ShawnHymel/Matrix_Badge/Images/border-film.png

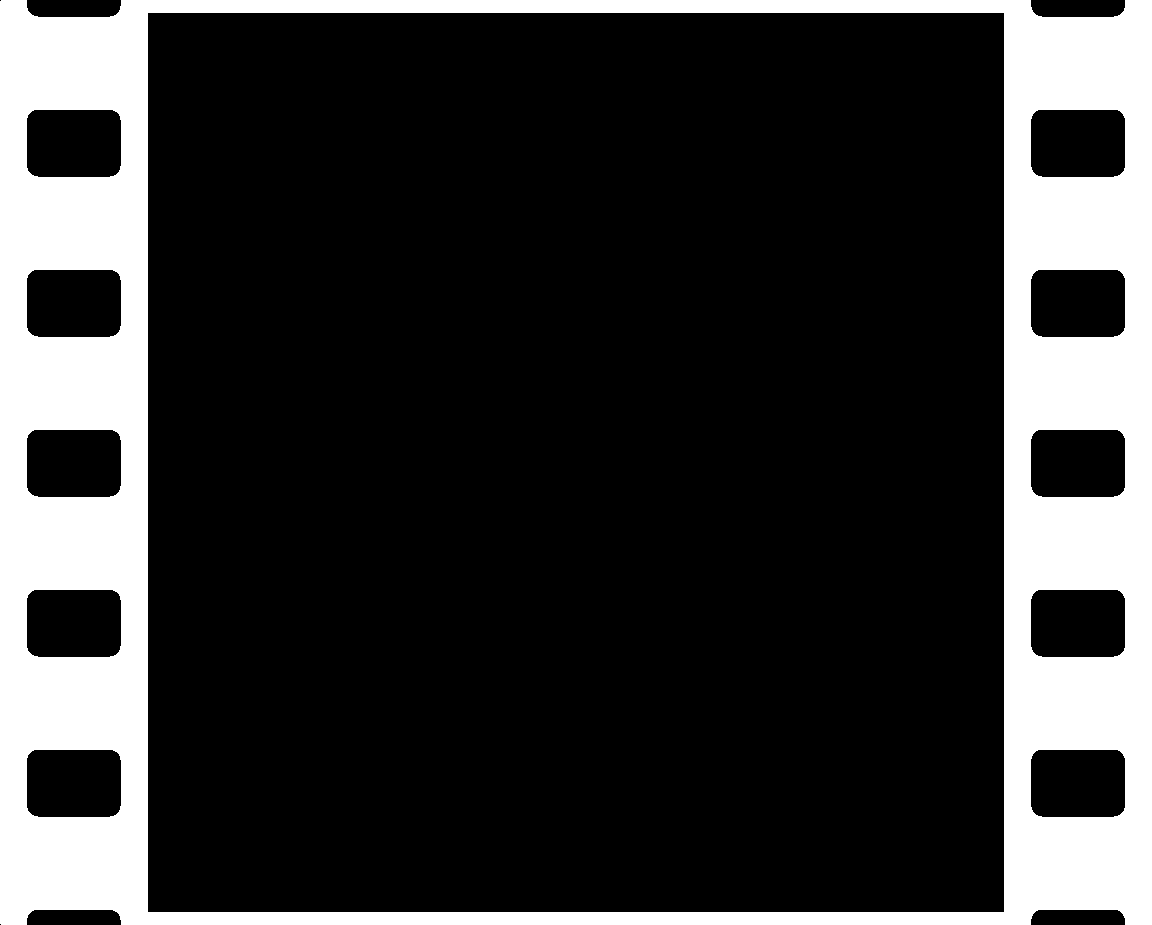
Images/border-film.png
