ShawnHymel/Matrix_Badge/Hardware/chplex-bom.xlsx

Reference | Quantity | Value | Footprint | MPN | Price/1 | Total Price/1 | Price/1k | Total Price/1k | Part Page
BT1 | 1 | Battery_Cell | Battery:BatteryHolder_Keystone_3034_1x20mm | 3034TR | $0.35000 | $0.35000 | $0.17504 | $0.17504 | https://www.digikey.com/product-detail/en/keystone-electronics/3034TR/36-3034CT-ND/4833649
C1 | 1 | 4.7uF | Capacitor_SMD:C_0805_2012Metric_Pad1.15x1.40mm_HandSolder | TMK212AB7475KG-T | $0.34000 | $0.34000 | $0.08151 | $0.08151 | https://www.digikey.com/product-detail/en/taiyo-yuden/TMK212AB7475KG-T/587-2990-1-ND/2714183
C2 | 1 | 0.1uF | Capacitor_SMD:C_0805_2012Metric_Pad1.15x1.40mm_HandSolder | 08055C104KAT2A | $0.22000 | $0.22000 | $0.04517 | $0.04517 | https://www.digikey.com/product-detail/en/avx-corporation/08055C104KAT2A/478-1395-1-ND/564427
D1-20 | 20 | LTST-C171KRKT | digikey-footprints:0805 | LTST-C171KRKT | $0.31000 | $6.20000 | $0.06007 | $1.20140 | https://www.digikey.com/product-detail/en/lite-on-inc/LTST-C171KRKT/160-1427-1-ND/386800
J1 | 1 | DNP | Connector_PinSocket_2.54mm:PinSocket_2x03_P2.54mm_Vertical | PRPC003DAAN-RC |  | $0.00000 |  | $0.00000 | https://www.digikey.com/product-detail/en/sullins-connector-solutions/PRPC003DAAN-RC/S2011EC-03-ND/2775291
R1 | 1 | 10k | Resistor_SMD:R_0805_2012Metric_Pad1.15x1.40mm_HandSolder | RC0805FR-0782RL | $0.10000 | $0.10000 | $0.00831 | $0.00831 | https://www.digikey.com/product-detail/en/yageo/RC0805FR-0710KL/311-10.0KCRCT-ND/730482
R2-6 | 5 | 82 | Resistor_SMD:R_0805_2012Metric_Pad1.15x1.40mm_HandSolder | RC0805FR-0710KL | $0.10000 | $0.50000 | $0.00831 | $0.04155 | https://www.digikey.com/product-detail/en/yageo/RC0805FR-0782RL/311-82.0CRCT-ND/731111
S1 | 1 | JS202011SCQN | digikey-footprints:Switch_Slide_JS202011SCQN | JS202011SCQN | $0.51000 | $0.51000 | $0.30561 | $0.30561 | https://www.digikey.com/product-detail/en/c-k/JS202011SCQN/401-2002-1-ND/1640098
U1 | 1 | ATTiny85V | digikey-footprints:SOIC-8_W5.3mm | ATTINY85V-10SU | $1.16000 | $1.16000 | $1.01971 | $1.01971 | https://www.digikey.com/product-detail/en/microchip-technology/ATTINY85V-10SU/ATTINY85V-10SU-ND/735472
BATT | 1 | CR2032 |  | CR2032 | $0.29000 | $0.29000 | $0.15734 | $0.15734 | https://www.digikey.com/product-detail/en/panasonic-bsg/CR2032/P189-ND/31939
PIN | 1 | Pin Back |  |  | $0.15980 | $0.15980 | $0.15980 | $0.15980 | https://www.amazon.com/dp/B01GFLNJQ4
BRD | 1 | PCB |  |  | $10.00000 | $10.00000 | $0.25000 | $0.25000
 |  |  |  | Totals: |  | $19.82980 |  | $3.44544
