ShawnHymel/Matrix_Badge/Hardware/matrix_badge/matrix_badge.kicad_pcb

## KiCad design Hardware/matrix_badge/matrix_badge.kicad_pcb (2019-03-03)

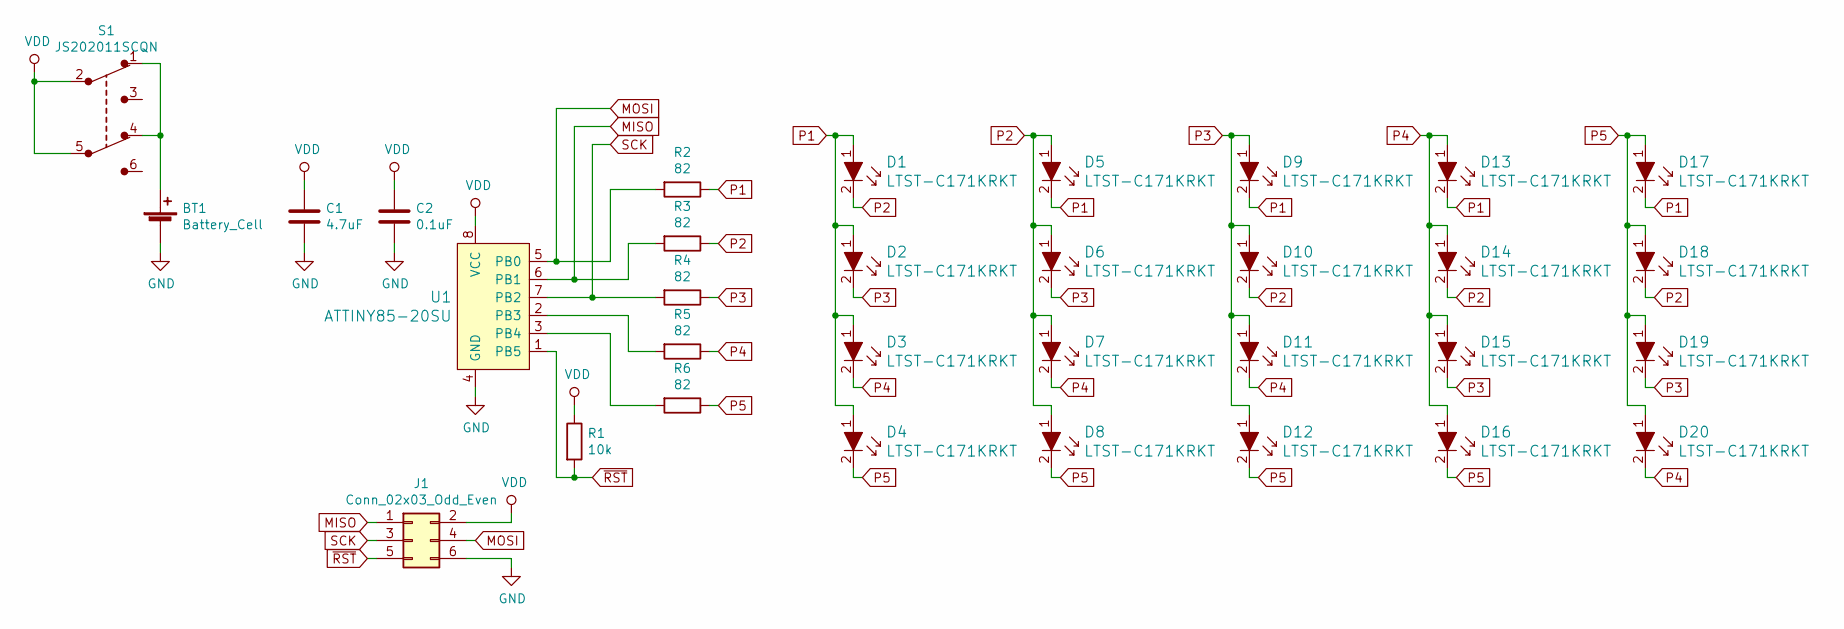
[picture p2: schematic matrix_badge.sch, Matrix Badge]

Parts:
BT1: Battery_Cell; BatteryHolder_Keystone_3034_1x20mm
C1: 4.7uF; C_0805_2012Metric_Pad1.15x1.40mm_HandSolder
C2: 0.1uF; C_0805_2012Metric_Pad1.15x1.40mm_HandSolder
D1, D2, D3, D4, D5, D6, D7, D8, D9, D10, D11, D12, D13, D14, D15, D16, D17, D18, D19, D20: LTST-C171KRKT; 0805; MPN LTST-C171KRKT; Digi-Key_PN 160-1427-1-ND
J1: Conn_02x03_Odd_Even; PinSocket_2x03_P2.54mm_Vertical
R1: 10k; R_0805_2012Metric_Pad1.15x1.40mm_HandSolder
R2, R3, R4, R5, R6: 82; R_0805_2012Metric_Pad1.15x1.40mm_HandSolder
S1: JS202011SCQN; Switch_Slide_JS202011SCQN; MPN JS202011SCQN; Digi-Key_PN 401-2002-1-ND
U1: ATTINY85-20SU; SOIJ-8_5.3x5.3mm_P1.27mm; MPN ATTINY85-20SU; Digi-Key_PN ATTINY85-20SU-ND

Connections:
GND: BT1.2 (-), C1.2, C2.2, J1.6, U1.4 (GND)
MISO: J1.1, R3.2, U1.6 (PB1)
MOSI: J1.4, R2.2, U1.5 (PB0)
unnamed: BT1.1 (+), S1.1, S1.4
unnamed: R5.2, U1.2 (PB3)
unnamed: R6.2, U1.3 (PB4)
P1: D1.1, D2.1, D3.1, D4.1, D5.2, D9.2, D13.2, D17.2, R2.1
P2: D1.2, D5.1, D6.1, D7.1, D8.1, D10.2, D14.2, D18.2, R3.1
P3: D2.2, D6.2, D9.1, D10.1, D11.1, D12.1, D15.2, D19.2, R4.1
P4: D3.2, D7.2, D11.2, D13.1, D14.1, D15.1, D16.1, D20.2, R5.1
P5: D4.2, D8.2, D12.2, D16.2, D17.1, D18.1, D19.1, D20.1, R6.1
SCK: J1.3, R4.2, U1.7 (PB2)
VDD: C1.1, C2.1, J1.2, R1.1, S1.2, S1.5, U1.8 (VCC)
~RST: J1.5, R1.2, U1.1 (PB5)

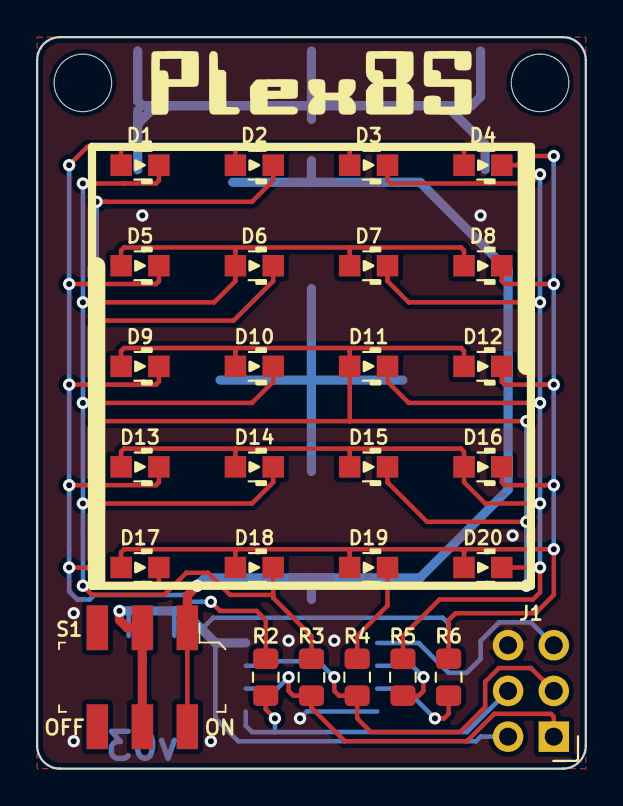
[picture p3: board matrix_badge.kicad_pcb from above]

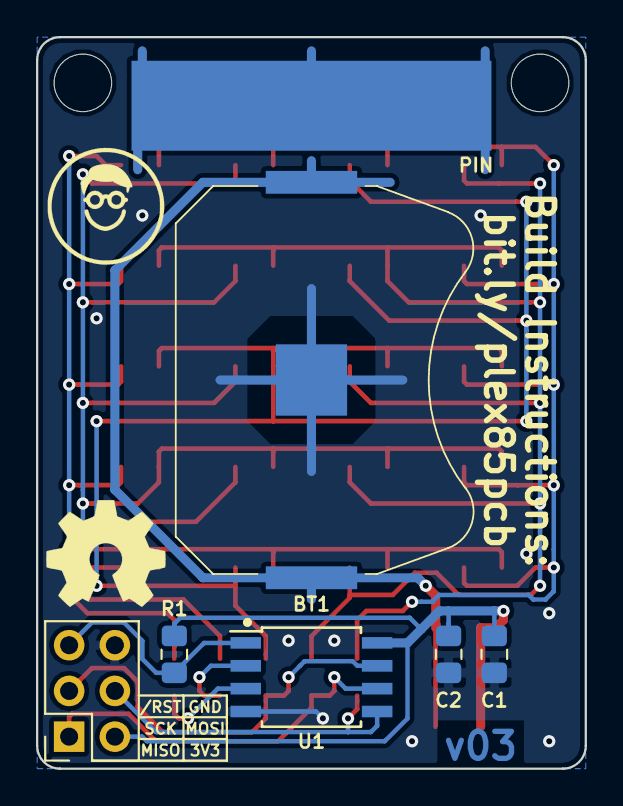
[picture p4: board matrix_badge.kicad_pcb from below]

Board: 2 copper layers, 30.5 x 40.6 mm, 33 parts (7 on the bottom side), 14 nets.

Other parts of the board:
PIN: pin_safety_sq_20mm
