ShawnHymel/Matrix_Badge/(commit log)

2019-01-31 Parts moved into initial spots
    [matrix_badge.kicad_pcb]
2019-01-31 Reconfigured footprint positions
    [matrix_badge.kicad_pcb]
2019-02-01 Layout ALMOST done. Missing 1 gnd connection.
    [matrix_badge.kicad_pcb]
2019-02-01 Finally got that last stupid #$%@# trace
    [matrix_badge.kicad_pcb]
2019-02-01 Added basic silkscreen
    [matrix_badge.kicad_pcb]
2019-02-01 Added pretty silkscreen. Well, pretty by my standards.
    [matrix_badge.kicad_pcb]
2019-02-02 Ran gerbers and made BOM
    [chplex-bom.xlsx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]
2019-02-05 Updated BOM with battery.
    [chplex-bom.xlsx]
2019-03-03 Made fixes for v02 (added wide body SOIC and swapped round pin for rectangular pin back). Added ON/OFF silk for v03.
    [matrix_badge-B.Cu.gbl, matrix_badge-B.Mask.gbs, matrix_badge-B.SilkS.gbo, matrix_badge-Edge.Cuts.gm1, matrix_badge-F.Cu.gtl, matrix_badge-F.Mask.gts, matrix_badge-F.SilkS.gto, matrix_badge-PTH.drl]
