ShawnHymel/Matrix_Badge/(notices)

Notices in the files:
Hardware/matrix_badge/matrix_badge.sch:
creativecommons.org/licenses/by/4.0
License: CC BY 4.0
